changl21/ECE445/ECE_445_PCB_3.0/ECE 445 Project 3.0/Project 2.0.kicad_pcb

## KiCad design ECE_445_PCB_3.0/ECE 445 Project 3.0/Project 2.0.kicad_pcb (2025-05-08)

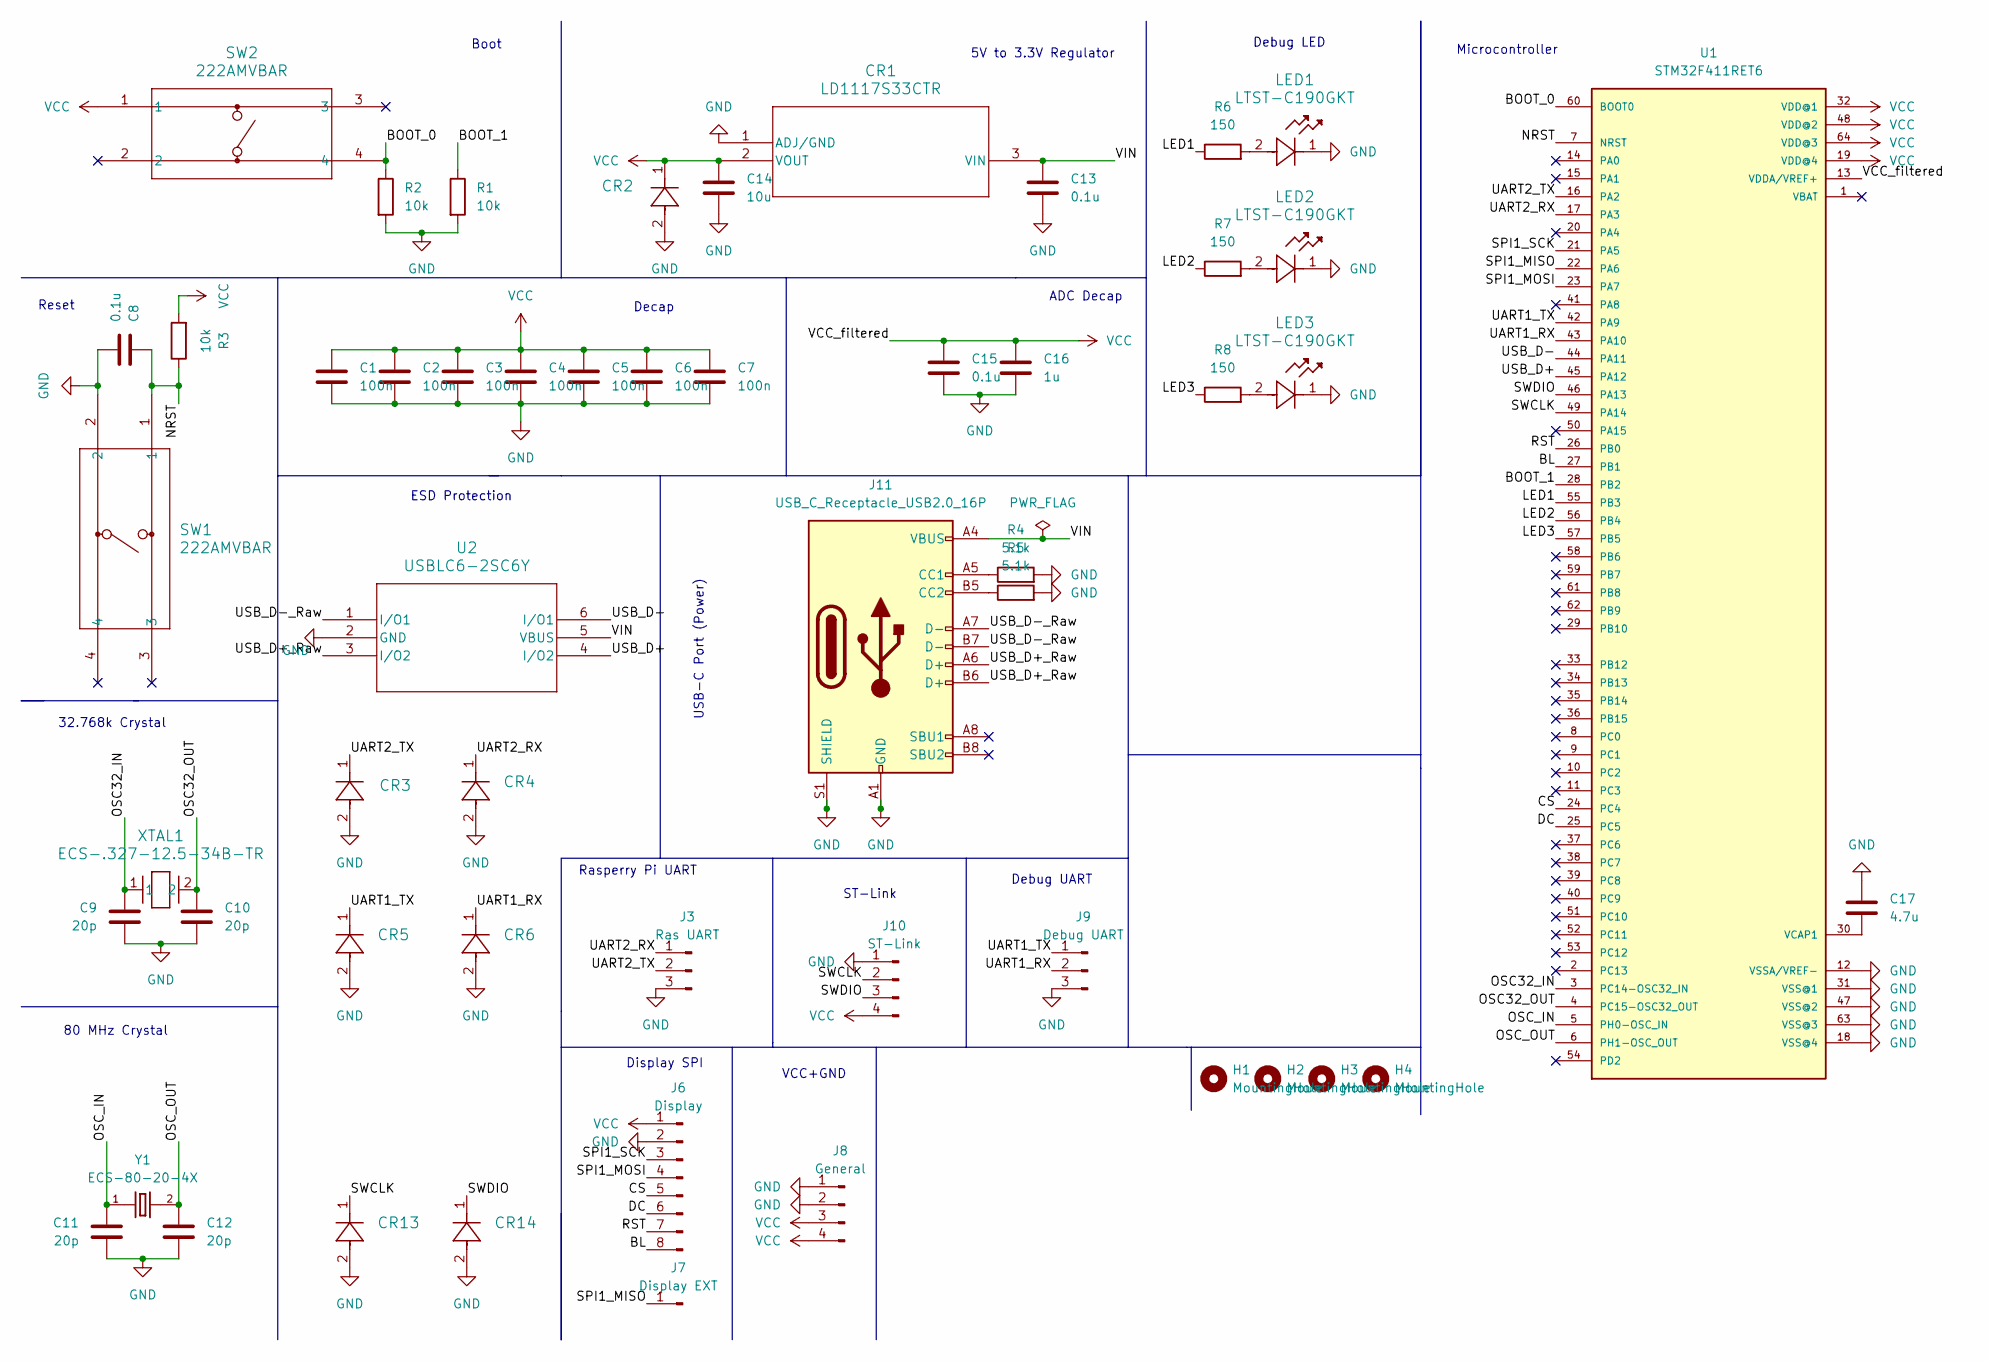
[picture p11: schematic Project 2.0.kicad_sch]

Parts:
C1, C2, C3, C4, C5, C6, C7: 100n; C_0603_1608Metric_Pad1.08x0.95mm_HandSolder
C8, C13, C15: 0.1u; C_0603_1608Metric_Pad1.08x0.95mm_HandSolder
C9, C10, C11, C12: 20p; C_0603_1608Metric_Pad1.08x0.95mm_HandSolder
C14: 10u; C_0805_2012Metric_Pad1.18x1.45mm_HandSolder
C16: 1u; C_0603_1608Metric_Pad1.08x0.95mm_HandSolder
C17: 4.7u; C_0603_1608Metric_Pad1.08x0.95mm_HandSolder
CR1: LD1117S33CTR; SOT-223_STM-L
CR2, CR3, CR4, CR5, CR6, CR13, CR14: PESD3V3L1BA_115; DIODE_PESD3V3L1BA_115_NEX-L
H1, H2, H3, H4: MountingHole; MountingHole_3.2mm_M3
J3: Ras UART; PinHeader_1x03_P2.54mm_Vertical
J6: Display; PinHeader_1x08_P2.54mm_Vertical
J7: Display EXT; PinHeader_1x01_P2.54mm_Vertical
J8: General; PinHeader_1x04_P2.54mm_Vertical
J9: Debug UART; PinHeader_1x03_P2.54mm_Vertical
J10: ST-Link; PinHeader_1x04_P2.54mm_Vertical
J11: USB_C_Receptacle_USB2.0_16P; USB_C_Receptacle_GCT_USB4105-xx-A_16P_TopMnt_Horizontal
LED1, LED2, LED3: LTST-C190GKT; LED_LTST-C190CKT_LTO
R1, R2, R3: 10k; R_0805_2012Metric_Pad1.20x1.40mm_HandSolder
R4, R5: 5.1k; R_0805_2012Metric_Pad1.20x1.40mm_HandSolder
R6, R7, R8: 150; R_0805_2012Metric_Pad1.20x1.40mm_HandSolder
SW1, SW2: 222AMVBAR; SO4_222A-M-V-B_CTS
U1: STM32F411RET6; QFP50P1200X1200X160-64N
U2: USBLC6-2SC6Y; SOT23-6L_STM-L
XTAL1: ECS-.327-12.5-34B-TR; XTAL_ECS-31B_ECS-L
Y1: ECS-80-20-4X; XTAL_ECS-80-20-4X

Connections:
/BL: J6.8, U1.27 (PB1)
/BOOT_0: R2.1, SW2.4, U1.60 (BOOT0)
/BOOT_1: R1.1, U1.28 (PB2)
/CS: J6.5, U1.24 (PC4)
/DC: J6.6, U1.25 (PC5)
/LED1: R6.1, U1.55 (PB3)
/LED2: R7.1, U1.56 (PB4)
/LED3: R8.1, U1.57 (PB5)
/NRST: C8.1, R3.1, SW1.1, U1.7 (NRST)
/OSC32_IN: C9.1, U1.3 (PC14-OSC32_IN), XTAL1.1
/OSC32_OUT: C10.1, U1.4 (PC15-OSC32_OUT), XTAL1.2
/OSC_IN: C11.1, U1.5 (PH0-OSC_IN), Y1.1
/OSC_OUT: C12.1, U1.6 (PH1-OSC_OUT), Y1.2
/RST: J6.7, U1.26 (PB0)
/SPI1_MISO: J7.1, U1.22 (PA6)
/SPI1_MOSI: J6.4, U1.23 (PA7)
/SPI1_SCK: J6.3, U1.21 (PA5)
/SWCLK: CR13.1, J10.2, U1.49 (PA14)
/SWDIO: CR14.1, J10.3, U1.46 (PA13)
/UART1_RX: CR6.1, J9.2, U1.43 (PA10)
/UART1_TX: CR5.1, J9.1, U1.42 (PA9)
/UART2_RX: CR4.1, J3.1, U1.17 (PA3)
/UART2_TX: CR3.1, J3.2, U1.16 (PA2)
/USB_D+: U1.45 (PA12), U2.4 (I/O2)
/USB_D+_Raw: J11.A6 (D+), J11.B6 (D+), U2.3 (I/O2)
/USB_D-: U1.44 (PA11), U2.6 (I/O1)
/USB_D-_Raw: J11.A7 (D-), J11.B7 (D-), U2.1 (I/O1)
/VIN: C13.1, CR1.3 (VIN), J11.A4 (VBUS), J11.A9 (VBUS), J11.B4 (VBUS), J11.B9 (VBUS), U2.5 (VBUS)
GND: C1.2, C2.2, C3.2, C4.2, C5.2, C6.2, C7.2, C8.2, C9.2, C10.2, C11.2, C12.2, C13.2, C14.2, C15.2, C16.2, C17.1, CR1.1 (ADJ/GND), CR2.2, CR3.2, CR4.2, CR5.2, CR6.2, CR13.2, CR14.2, J3.3, J6.2, J8.1, J8.2, J9.3, J10.1, J11.A1 (GND), J11.A12 (GND), J11.B1 (GND), J11.B12 (GND), J11.S1 (SHIELD), LED1.1, LED2.1, LED3.1, R1.2, R2.2, R4.2, R5.2, SW1.2, U1.12 (VSSA/VREF-), U1.18 (VSS@4), U1.31 (VSS@1), U1.47 (VSS@2), U1.63 (VSS@3), U2.2 (GND)
unnamed: J11.A5 (CC1), R4.1
unnamed: J11.B5 (CC2), R5.1
unnamed: LED1.2, R6.2
unnamed: LED2.2, R7.2
unnamed: LED3.2, R8.2
unnamed: C17.2, U1.30 (VCAP1)
VCC: C1.1, C2.1, C3.1, C4.1, C5.1, C6.1, C7.1, C14.1, C15.1, C16.1, CR1.2 (VOUT), CR2.1, J6.1, J8.3, J8.4, J10.4, R3.2, SW2.1, U1.13 (VDDA/VREF+), U1.19 (VDD@4), U1.32 (VDD@1), U1.48 (VDD@2), U1.64 (VDD@3)

Notes on the sheet:
Microcontroller
Rasperry Pi UART
Boot
Debug LED
32.768k Crystal
Reset
Debug UART
USB-C Port (Power)
ADC Decap
VCC+GND
Display SPI
Decap
ST-Link
ESD Protection
5V to 3.3V Regulator
80 MHz Crystal

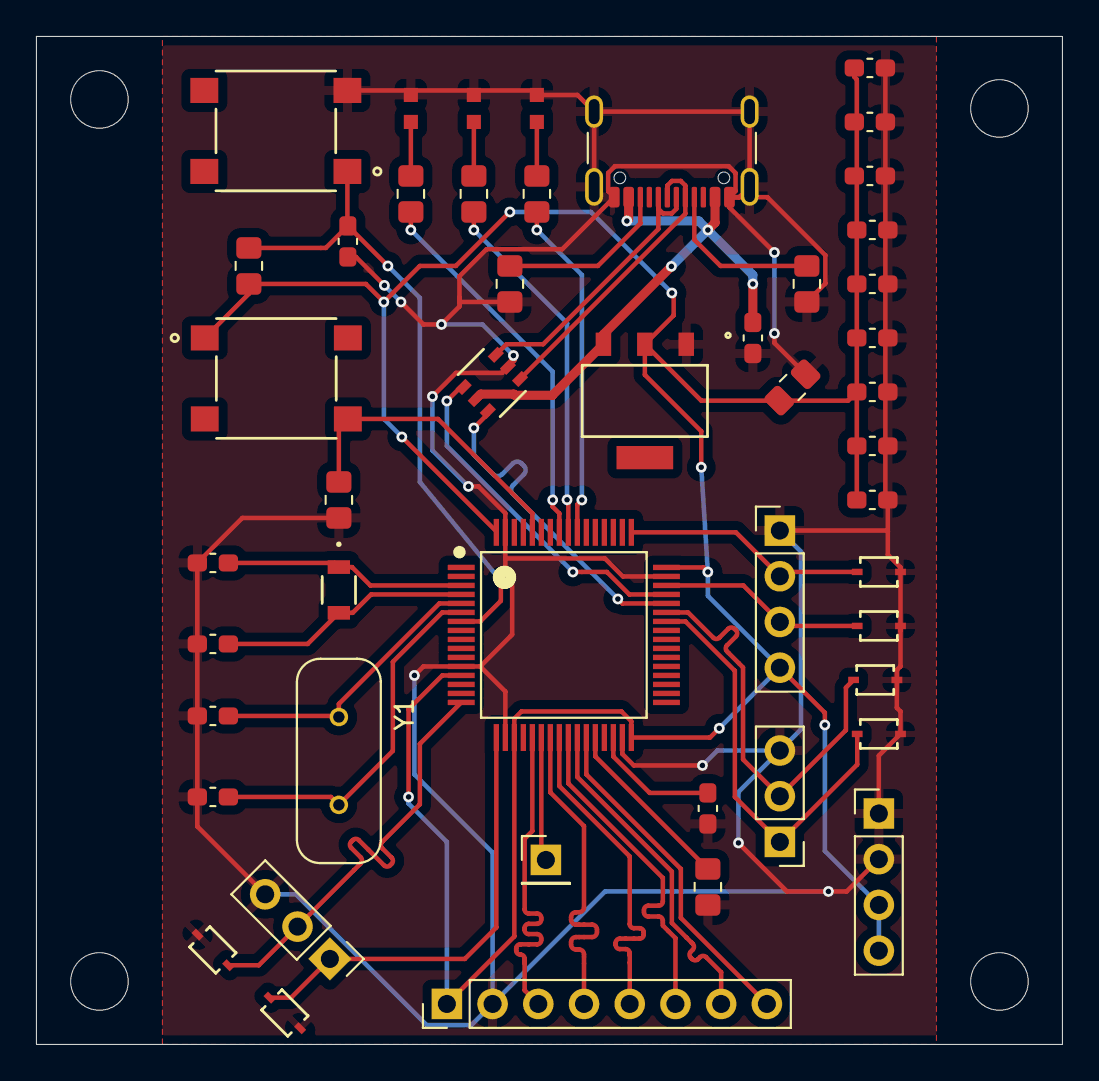
[picture p12: board Project 2.0.kicad_pcb from above]

Board: 2 copper layers, 57.0 x 56.0 mm, 52 parts (0 on the bottom side), 36 nets.
