changl21/ECE445/STM32_Script/445_Final/Core/Src/main.c

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
/* Includes ------------------------------------------------------------------*/
#include "main.h"

/* USER CODE BEGIN Includes */
#include "ili9341.h"
#include "fonts.h"
#include <string.h>
#include <stdbool.h>
/* USER CODE END Includes */

SPI_HandleTypeDef hspi1;

UART_HandleTypeDef huart1;
UART_HandleTypeDef huart2;

/* USER CODE BEGIN PV */
char rx_char;
char word_buffer[64];
int word_index = 0;
char display_line[256];
int line_index = 0;
/* USER CODE END PV */

void SystemClock_Config(void);
static void MX_GPIO_Init(void);
static void MX_USART2_UART_Init(void);
static void MX_SPI1_Init(void);
static void MX_USART1_UART_Init(void);
/**
  * @brief  The application entry point.
  * @retval int
  */
int main(void)
{

  /* MCU Configuration--------------------------------------------------------*/

  /* Reset of all peripherals, Initializes the Flash interface and the Systick. */
  HAL_Init();

  /* Configure the system clock */
  SystemClock_Config();

  /* Initialize all configured peripherals */
  MX_GPIO_Init();
  MX_USART2_UART_Init();
  MX_SPI1_Init();
  MX_USART1_UART_Init();
  /* USER CODE BEGIN 2 */
  // Initialize ILI9341 LCD and clear the screen
  ILI9341_Init();
  ILI9341_FillScreen(ILI9341_BLACK);
  // (Optional) Set rotation if your application requires it, e.g.,:
  // ILI9341_SetRotation(ILI9341_MADCTL_MX | ILI9341_MADCTL_BGR);

  /* USER CODE END 2 */

  /* Infinite loop */
  /* USER CODE BEGIN WHILE */
  while (1)
  {
    /* USER CODE END WHILE */
	if (HAL_UART_Receive(&huart1, (uint8_t *)&rx_char, 1, HAL_MAX_DELAY) == HAL_OK)
	{
		if (rx_char == '\n')
		{
			word_buffer[word_index] = '\0';
			word_index = 0;

			if (strcmp(word_buffer, "[FLUSH]") == 0)
			{
				ILI9341_FillScreen(ILI9341_BLACK);
				ILI9341_WriteString(10, 10, display_line, Font_11x18, ILI9341_WHITE, ILI9341_BLACK);
				line_index = 0;
				display_line[0] = '\0';  // reset buffer
			}
			else
			{
				if (line_index + strlen(word_buffer) + 1 < sizeof(display_line))
				{
					strcat(display_line, word_buffer);
					strcat(display_line, " ");
					line_index = strlen(display_line);
				}
			}
		}
		else if (word_index < sizeof(word_buffer) - 1)
		{
			word_buffer[word_index++] = rx_char;
		}
	}
    /* USER CODE BEGIN 3 */
  }
  /* USER CODE END 3 */
}

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
