changl21/ECE445/(notices)

Notices in the files:
STM32_Script/445_Final/Core/Inc/main.h:
Copyright (c) 2025 STMicroelectronics.
All rights reserved.
This software is licensed under terms that can be found in the LICENSE file
